Ken-2511/LDO/ldo/LDO_BOM.csv

Comment | Qty | Designator | Footprint | MPN | LCSC Part #
47uF 10V | 2 | C1,C3 | Capacitor_SMD:C_1206_3216Metric_Pad1.33x1.80mm_HandSolder | CL31A476MPHNNNE | C96123
4.7uF 10V | 1 | C2 | Capacitor_SMD:C_0805_2012Metric_Pad1.18x1.45mm_HandSolder | CL21B475KAFNNNE | C98195
10uF | 1 | C4 | Capacitor_SMD:C_0805_2012Metric_Pad1.18x1.45mm_HandSolder | CL21A106KAYNNNE | C15850
100nF | 2 | C5,C7 | Capacitor_SMD:C_0603_1608Metric_Pad1.08x0.95mm_HandSolder | CL10B104KB8NNNC | C1591
1uF | 2 | C6,C8 | Capacitor_SMD:C_0603_1608Metric_Pad1.08x0.95mm_HandSolder | CL10B105KA8NNNC | C29936
Stack_2x05 | 1 | J1 | Connector_PinSocket_2.54mm:PinSocket_2x05_P2.54mm_Vertical
VOUT | 1 | J3 | Connector_PinHeader_2.54mm:PinHeader_1x02_P2.54mm_Horizontal | PZ254R-11-02P | C492410
4.7 | 1 | R1 | Resistor_SMD:R_0805_2012Metric_Pad1.20x1.40mm_HandSolder | SR0805FR-7W4R7L | C873778
1k 0.1% | 1 | R2 | Resistor_SMD:R_0603_1608Metric_Pad0.98x0.95mm_HandSolder | RT0603BRD071KL | C110776
1k 1% | 1 | R3 | Resistor_SMD:R_0603_1608Metric_Pad0.98x0.95mm_HandSolder | 0603WAF1001T5E | C21190
0.5 1% | 1 | R4 | Resistor_SMD:R_1206_3216Metric_Pad1.30x1.75mm_HandSolder | RL1206FR-070R5L | C327075
10k | 1 | R5 | Resistor_SMD:R_0603_1608Metric_Pad0.98x0.95mm_HandSolder | 0603WAF1002T5E | C25804
LT3042xMSE | 1 | U1 | Package_SO:MSOP-10-1EP_3x3mm_P0.5mm_EP1.68x1.88mm | LT3042EMSE#PBF | C69847
DAC60502 | 1 | U2 | Package_SON:Texas_DRX_WSON-10_2.5x2.5mm_P0.5mm | DAC60502DRXR | C2876322
INA226 | 1 | U3 | Package_SO:TSSOP-10_3x3mm_P0.5mm | INA226AIDGSR | C49851
