Ken-2511/LDO/controller/controller.kicad_pcb

## KiCad design controller/controller.kicad_pcb (2026-10-26)

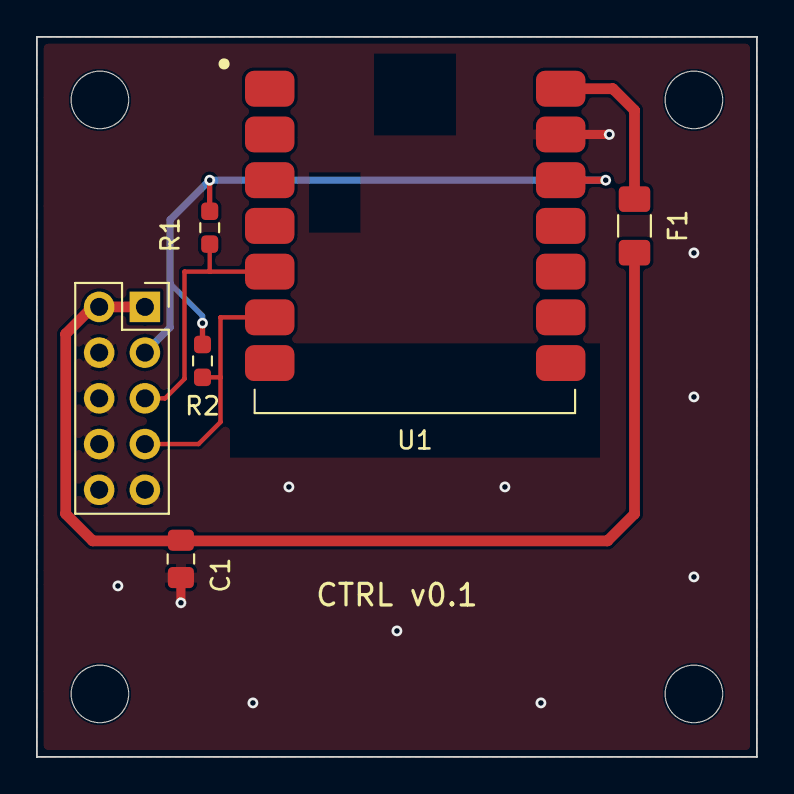
[picture p1: board controller.kicad_pcb from above]

Board: 2 copper layers, 40.0 x 40.0 mm, 10 parts (0 on the bottom side), 6 nets.

Parts:
C1: 10uF 25V; C_0805_2012Metric_Pad1.18x1.45mm_HandSolder
F1: 500mA; Fuse_1206_3216Metric_Pad1.42x1.75mm_HandSolder
H1, H2, H3, H4: M3; MountingHole_3.2mm_M3
J1: Stack_2x05; PinSocket_2x05_P2.54mm_Vertical
R1, R2: 4.7k; R_0603_1608Metric_Pad0.98x0.95mm_HandSolder
U1: XIAO_nRF52840; XIAO_nRF52840_SMD

Connections:
+3V3: J1.3, R1.1, R2.1, U1.12
+5V: C1.1, F1.2, J1.1, J1.2
/SCL: J1.7, R2.2, U1.6
/SDA: J1.5, R1.2, U1.5
/VBUS: F1.1, U1.14
GND: C1.2, J1.4, J1.6, J1.8, J1.9, J1.10, U1.13
