Ken-2511/LDO/ldo/LDO.kicad_pcb

## KiCad design ldo/LDO.kicad_pcb (2026-10-26)

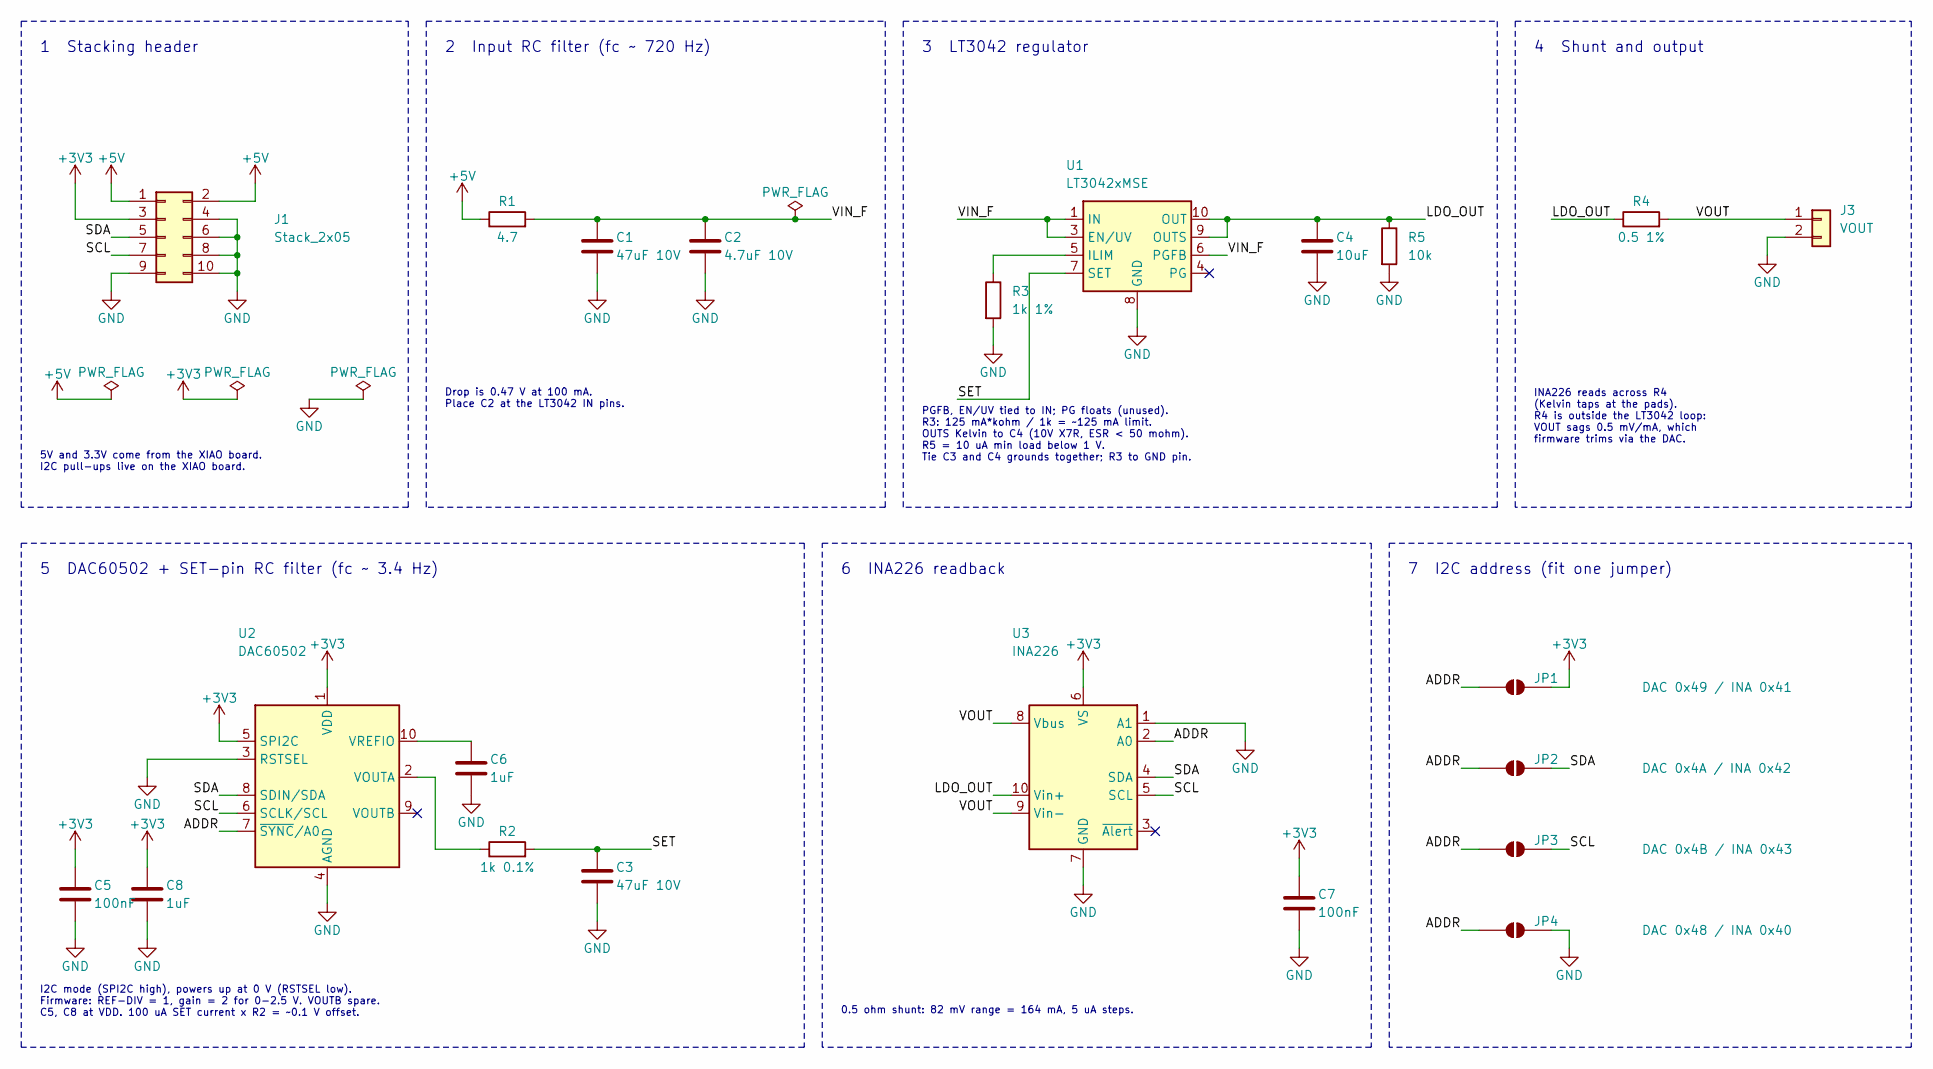
[picture p2: schematic LDO.kicad_sch, LDO board - BLE stackable low-noise supply]

Parts:
C1, C3: 47uF 10V; C_1206_3216Metric_Pad1.33x1.80mm_HandSolder; MPN CL31A476MPHNNNE; LCSC C96123
C2: 4.7uF 10V; C_0805_2012Metric_Pad1.18x1.45mm_HandSolder; MPN CL21B475KAFNNNE; LCSC C98195
C4: 10uF; C_0805_2012Metric_Pad1.18x1.45mm_HandSolder; MPN CL21A106KAYNNNE; LCSC C15850
C5, C7: 100nF; C_0603_1608Metric_Pad1.08x0.95mm_HandSolder; MPN CL10B104KB8NNNC; LCSC C1591
C6, C8: 1uF; C_0603_1608Metric_Pad1.08x0.95mm_HandSolder; MPN CL10B105KA8NNNC; LCSC C29936
J1: Stack_2x05; PinSocket_2x05_P2.54mm_Vertical
J3: VOUT; PinHeader_1x02_P2.54mm_Horizontal; MPN PZ254R-11-02P; LCSC C492410
JP1: DAC 0x49 / INA 0x41; SolderJumper-2_P1.3mm_Open_RoundedPad1.0x1.5mm
JP2: DAC 0x4A / INA 0x42; SolderJumper-2_P1.3mm_Open_RoundedPad1.0x1.5mm
JP3: DAC 0x4B / INA 0x43; SolderJumper-2_P1.3mm_Open_RoundedPad1.0x1.5mm
JP4: DAC 0x48 / INA 0x40; SolderJumper-2_P1.3mm_Open_RoundedPad1.0x1.5mm
R1: 4.7; R_0805_2012Metric_Pad1.20x1.40mm_HandSolder; MPN SR0805FR-7W4R7L; LCSC C873778
R2: 1k 0.1%; R_0603_1608Metric_Pad0.98x0.95mm_HandSolder; MPN RT0603BRD071KL; LCSC C110776
R3: 1k 1%; R_0603_1608Metric_Pad0.98x0.95mm_HandSolder; MPN 0603WAF1001T5E; LCSC C21190
R4: 0.5 1%; R_1206_3216Metric_Pad1.30x1.75mm_HandSolder; MPN RL1206FR-070R5L; LCSC C327075
R5: 10k; R_0603_1608Metric_Pad0.98x0.95mm_HandSolder; MPN 0603WAF1002T5E; LCSC C25804
U1: LT3042xMSE; MSOP-10-1EP_3x3mm_P0.5mm_EP1.68x1.88mm; MPN LT3042EMSE#PBF; LCSC C69847
U2: DAC60502; Texas_DRX_WSON-10_2.5x2.5mm_P0.5mm; MPN DAC60502DRXR; LCSC C2876322
U3: INA226; TSSOP-10_3x3mm_P0.5mm; MPN INA226AIDGSR; LCSC C49851

Connections:
+3V3: C5.1, C7.1, C8.1, J1.3, JP1.2 (B), U2.1 (VDD), U2.5 (SPI2C), U3.6 (VS)
+5V: J1.1, J1.2, R1.1
/ADDR: JP1.1 (A), JP2.1 (A), JP3.1 (A), JP4.1 (A), U2.7 (~SYNC/A0), U3.2 (A0)
/LDO_OUT: C4.1, R4.1, R5.1, U1.9 (OUTS), U1.10 (OUT), U3.10 (Vin+)
/SCL: J1.7, JP3.2 (B), U2.6 (SCLK/SCL), U3.5 (SCL)
/SDA: J1.5, JP2.2 (B), U2.8 (SDIN/SDA), U3.4 (SDA)
/SET: C3.1, R2.2, U1.7 (SET)
/VIN_F: C1.1, C2.1, R1.2, U1.1 (IN), U1.2 (IN), U1.3 (EN/UV), U1.6 (PGFB)
/VOUT: J3.1, R4.2, U3.8 (Vbus), U3.9 (Vin-)
GND: C1.2, C2.2, C3.2, C4.2, C5.2, C6.2, C7.2, C8.2, J1.4, J1.6, J1.8, J1.9, J1.10, J3.2, JP4.2 (B), R3.2, R5.2, U1.8 (GND), U1.11 (GND), U2.3 (RSTSEL), U2.4 (AGND), U3.1 (A1), U3.7 (GND)
unnamed: R3.1, U1.5 (ILIM)
unnamed: R2.1, U2.2 (VOUTA)
unnamed: C6.1, U2.10 (VREFIO)

Notes on the sheet:
1 Stacking header
5V and 3.3V come from the XIAO board. I2C pull-ups live on the XIAO board.
2 Input RC filter (fc ~ 720 Hz)
Drop is 0.47 V at 100 mA. Place C2 at the LT3042 IN pins.
3 LT3042 regulator
PGFB, EN/UV tied to IN; PG floats (unused). R3: 125 mA*kohm / 1k = ~125 mA limit. OUTS Kelvin to C4 (10V X7R, ESR < 50 mohm). R5 = 10 uA min load below 1 V. Tie C3 and C4 grounds together; R3 to GND pin.
4 Shunt and output
INA226 reads across R4 (Kelvin taps at the pads). R4 is outside the LT3042 loop: VOUT sags 0.5 mV/mA, which firmware trims via the DAC.
5 DAC60502 + SET-pin RC filter (fc ~ 3.4 Hz)
I2C mode (SPI2C high), powers up at 0 V (RSTSEL low). Firmware: REF-DIV = 1, gain = 2 for 0-2.5 V. VOUTB spare. C5, C8 at VDD. 100 uA SET current x R2 = ~0.1 V offset.
6 INA226 readback
0.5 ohm shunt: 82 mV range = 164 mA, 5 uA steps.
7 I2C address (fit one jumper)

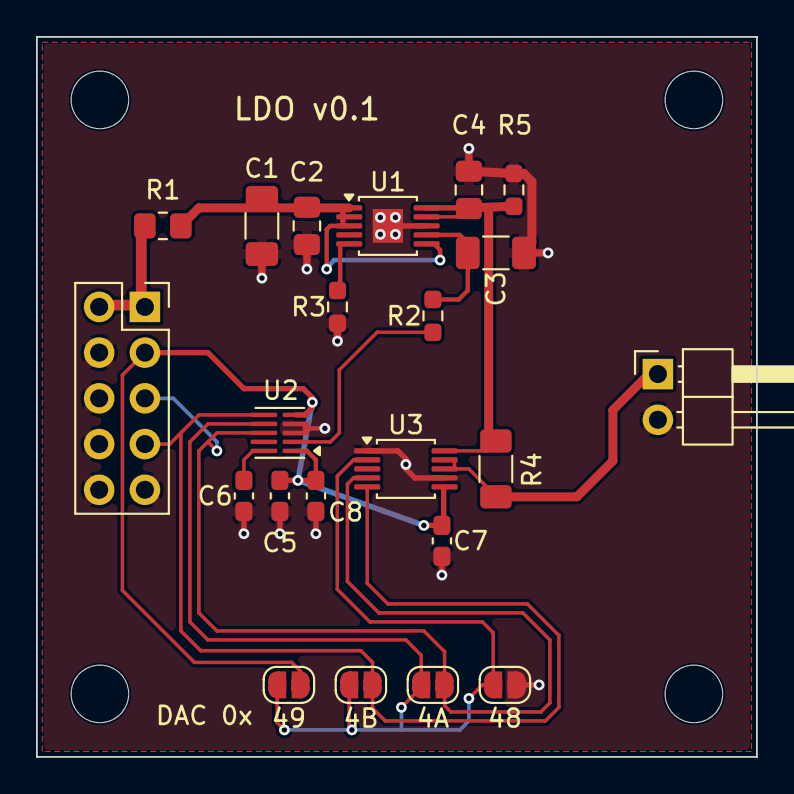
[picture p3: board LDO.kicad_pcb from above]

Board: 2 copper layers, 40.0 x 40.0 mm, 26 parts (0 on the bottom side), 13 nets.

Other parts of the board:
H1, H2, H3, H4: M3; MountingHole_3.2mm_M3
