Ken-2511/LDO/(commit log)

2026-10-24 Initial KiCad project
    [LDO.kicad_pcb, LDO.kicad_sch]
2026-10-24 Draw LDO board schematic
    One LT3042 channel set by a DAC60502 through an RC filter on SET,
    read back by an INA226 across a 0.5 ohm shunt, with a 2x5 stacking
    header and solder-jumper I2C address select.
    [LDO.kicad_sch]
2026-10-24 Fix LT3042 connections per datasheet
    - Tie OUTS to OUT at C4 so the shunt stays outside the regulation loop
    - Set ILIM with 1k (125 mA*kohm scale factor, ~125 mA limit)
    - Add R5 10k minimum load for stability below 1 V
    [LDO.kicad_sch]
2026-10-25 Add second 5V header pin and right-angle output header
    - J1 pin 2 now carries 5V (two 5V pins, five GND pins)
    - J3: 2-pin 2.54 mm right-angle header in parallel with the screw terminal
    [LDO.kicad_sch]
2026-10-25 Place and route the LDO board
    - 40x40 mm 2-layer board with M3 corner holes, J1 stacking header on the left edge
    - Small passives moved to 0603; jumpers excluded from the BOM; stable symbol IDs
    - Solid GND fill on both layers with thermal reliefs for hand and hot-plate soldering
    - LT3042 routed per datasheet: OUTS Kelvin at C4, C3/C4 grounds tied, thermal vias
    - INA226 Kelvin taps on the shunt, I2C/ADDR fan-out, 45-degree corners throughout
    - Ignore KiCad .history/
    [LDO.kicad_pcb, LDO.kicad_sch]
2026-10-26 Drop screw terminal, fix silkscreen, add LCSC parts and BOM
    - Remove J2 screw terminal (13.8 mm, too tall for the stack); J3 header is the output
    - Silkscreen labels 1.0 mm / 0.15 mm, add LDO v0.1 and DAC address labels
    - MPN and LCSC fields on every orderable part, matched in schematic and PCB
    - LDO_BOM.csv exported from the schematic
    [LDO.kicad_pcb, LDO.kicad_sch, LDO_BOM.csv]
2026-10-26 Center J3 on the right edge and add v0.1 fabrication files
    - J3 pins straddle the board's 20 mm midline; VOUT rerouted with 0.5 mm, 45-degree trace
    - Gerbers and Excellon drills for JLCPCB (2 layers, 40x40 mm) zipped under fabrication/
    [LDO.kicad_pcb]
2026-10-26 Switch R1 to an in-stock part and drop J1's LCSC number
    - R1: Yageo SR0805FR-7W4R7L (LCSC C873778, 250 mW); C137513 was out of stock
    - J1: remove MPN/LCSC; the long-pin stacking socket is sourced separately
    [LDO.kicad_pcb, LDO.kicad_sch, LDO_BOM.csv]
2026-10-26 Split the repo into ldo/ and controller/ KiCad projects
    Move the LDO board into ldo/ and add an empty controller project with
    the 40x40 mm outline, M3 holes and the J1 stacking socket at the same
    position as on the LDO board. Add a short README describing the stack.
    [LDO.kicad_pcb, LDO.kicad_sch, LDO_BOM.csv, controller.kicad_pcb, controller.kicad_sch]
2026-10-26 Draw, place and route the controller board
    Add a project-local XIAO nRF52840 symbol and castellated footprint, the
    500 mA PTC fuse, 10 uF bulk cap and 4.7k I2C pull-ups. The XIAO sits at
    the top edge with USB-C overhanging and a copper keepout under its
    antenna. Add the BOM with LCSC numbers and the v0.1 Gerber zip.
    [controller.kicad_pcb, controller.kicad_sch, controller_BOM.csv]
2026-10-26 Match the XIAO footprint to Seeed's official one
    Move the castellated pads to the positions and size in Seeed's
    XIAO-nRF52840-SMD footprint and match its body outline. Keep the ground
    pour out from under the module's SWD and battery pads. Regenerate the
    v0.1 Gerber zip.
    [controller.kicad_pcb]
2026-10-26 Save KiCad's default ERC settings in the controller project
2026-11-07 Add the BLE web GUI for setting and reading the LDO boards
    A single page that connects to the XIAO over Web Bluetooth (Nordic UART
    Service), scans the I2C bus, sets each board's output voltage and shows
    live voltage and current. .nojekyll lets GitHub Pages serve it as-is.
2026-11-07 Add the XIAO firmware for setting and reading the LDO boards
    Answers one-line commands over USB serial and BLE (Nordic UART Service):
    ping, scan, r/w for raw registers, set for the output target and read
    for the INA226 voltage and current. It sets the DAC60502 REF-DIV bit so
    the outputs work at 3.3 V, and every 100 ms it raises the DAC by the
    shunt drop across R4 so the output at J3 holds its target under load.
